Regeneric/universal-board-computer/(list of files, drawings)

Other design files:
sketch/bc-kkk.simu
sketch/bc-kkk_backup.simu
