Regeneric/universal-board-computer/sketch/universal_bc202.brd

## EAGLE design sketch/universal_bc202.brd (2021-03-08)

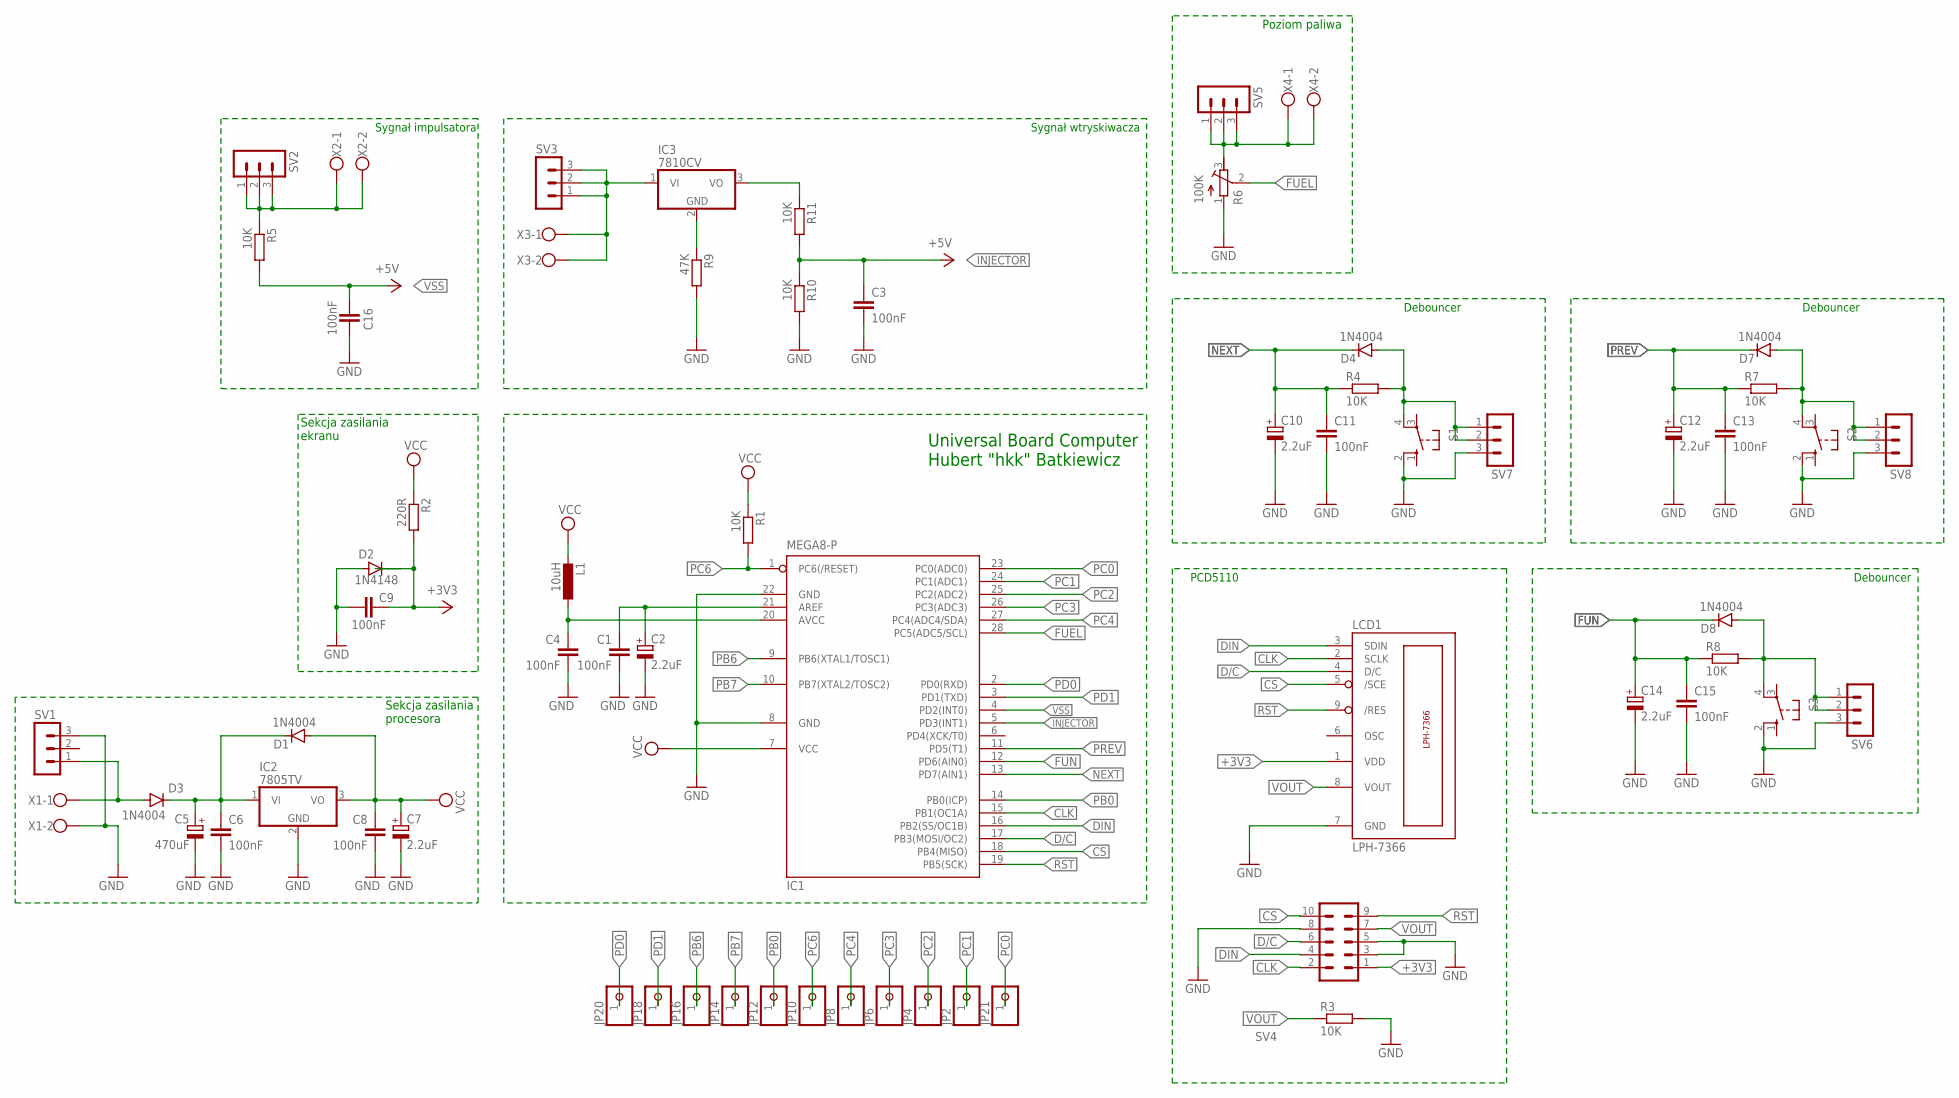
[picture p1: schematic universal_bc.sch]

Parts:
C1, C3, C4, C6, C8, C9, C11, C13, C15, C16: 100nF; C025-025X050
C2, C7, C10, C12, C14: 2.2uF; E2,5-6E
C5: 470uF; E2,5-6E
D1, D3, D4, D7, D8: 1N4004; DO41-10
D2: 1N4148; DO35-7
IC1: MEGA8-P; DIL28-3
IC2: 7805TV; TO220V
IC3: 7810CV; TO220V
JP2, JP4, JP6, JP8, JP10, JP12, JP14, JP16, JP18, JP20, JP21: PINHD-1X1; 1X01
L1: 10uH; 0207/2V
LCD1: LPH-7366
R1, R3, R4, R5, R7, R8, R10, R11: 10K; 0207/10
R2: 220R; 0207/10
R6: 100K; RTRIM3339P
R9: 47K; 0207/10
S1, S2, S3: 10-XX; B3F-10XX
SV1, SV2, SV3, SV5, SV6, SV7, SV8: MA03-1
SV4: MA05-2
X1, X2, X3, X4: W237-102

Connections:
+3V3: C9.1, D2.C, LCD1.1 (VDD), R2.2, SV4.1
CLK: IC1.15 (PB1(OC1A)), LCD1.2 (SCLK), SV4.2
CS: IC1.18 (PB4(MISO)), LCD1.5 (/SCE), SV4.10
D/C: IC1.17 (PB3(MOSI/OC2)), LCD1.4 (D/C), SV4.6
DIN: IC1.16 (PB2(SS/OC1B)), LCD1.3 (SDIN), SV4.4
FLOAT: R6.3 (E), SV5.1, SV5.2, SV5.3, X4.1, X4.2
FUEL: IC1.28 (PC5(ADC5/SCL)), R6.2 (S)
FUN: C14.+, C15.1, D8.C, IC1.12 (PD6(AIN0)), R8.1
GND: C1.2, C2.-, C3.2, C4.2, C5.-, C6.2, C7.-, C8.2, C9.2, C10.-, C11.2, C12.-, C13.2, C14.-, C15.2, C16.1, D2.A, IC1.8 (GND), IC1.22 (GND), IC2.2 (GND), LCD1.7 (GND), R3.2, R6.1 (A), R9.2, R10.2, S1.2 (S1), S2.2 (S1), S3.2 (S1), SV1.3, SV4.3, SV4.5, SV4.8, SV6.3, SV7.3, SV8.3, X1.2; also elsewhere on the board
INJECTOR: C3.1, IC1.5 (PD3(INT1)), R10.1, R11.2
unnamed: C1.1, C2.+, IC1.21 (AREF)
unnamed: C4.1, IC1.20 (AVCC), L1.1
unnamed: C5.+, C6.1, D1.C, D3.C, IC2.1 (VI)
unnamed: IC3.1 (VI), SV3.1, SV3.2, SV3.3, X3.1, X3.2
unnamed: D4.A, R4.2, S1.4 (P1), SV7.1, SV7.2
unnamed: D7.A, R7.2, S2.4 (P1), SV8.1, SV8.2
unnamed: D8.A, R8.2, S3.4 (P1), SV6.1, SV6.2
unnamed: D3.A, SV1.1, X1.1
unnamed: R5.1, SV2.1, SV2.2, SV2.3, X2.1, X2.2
unnamed: IC3.2 (GND), R9.1
unnamed: IC3.3 (VO), R11.1
NEXT: C10.+, C11.1, D4.C, IC1.13 (PD7(AIN1)), R4.1
PB0: IC1.14 (PB0(ICP)), JP12.1
PB6: IC1.9 (PB6(XTAL1/TOSC1)), JP16.1
PB7: IC1.10 (PB7(XTAL2/TOSC2)), JP14.1
PC0: IC1.23 (PC0(ADC0)), JP21.1
PC1: IC1.24 (PC1(ADC1)), JP2.1
PC2: IC1.25 (PC2(ADC2)), JP4.1
PC3: IC1.26 (PC3(ADC3)), JP6.1
PC4: IC1.27 (PC4(ADC4/SDA)), JP8.1
PC6: IC1.1 (PC6(/RESET)), JP10.1, R1.2; also elsewhere on the board
PD0: IC1.2 (PD0(RXD)), JP20.1
PD1: IC1.3 (PD1(TXD)), JP18.1
PREV: C12.+, C13.1, D7.C, IC1.11 (PD5(T1)), R7.1
RST: IC1.19 (PB5(SCK)), LCD1.9 (/RES), SV4.9
VCC: C7.+, C8.1, D1.A, IC1.7 (VCC), IC2.3 (VO), L1.2, R1.1, R2.1; also elsewhere on the board
VOUT: LCD1.8 (VOUT), R3.1, SV4.7
VSS: C16.2, IC1.4 (PD2(INT0)), R5.2

Notes on the sheet:
Sekcja zasilania procesora
Sekcja zasilania ekranu
Universal Board Computer Hubert "hkk" Batkiewicz
PCD5110
Sygnał impulsatora
Debouncer
Sygnał wtryskiwacza
Poziom paliwa

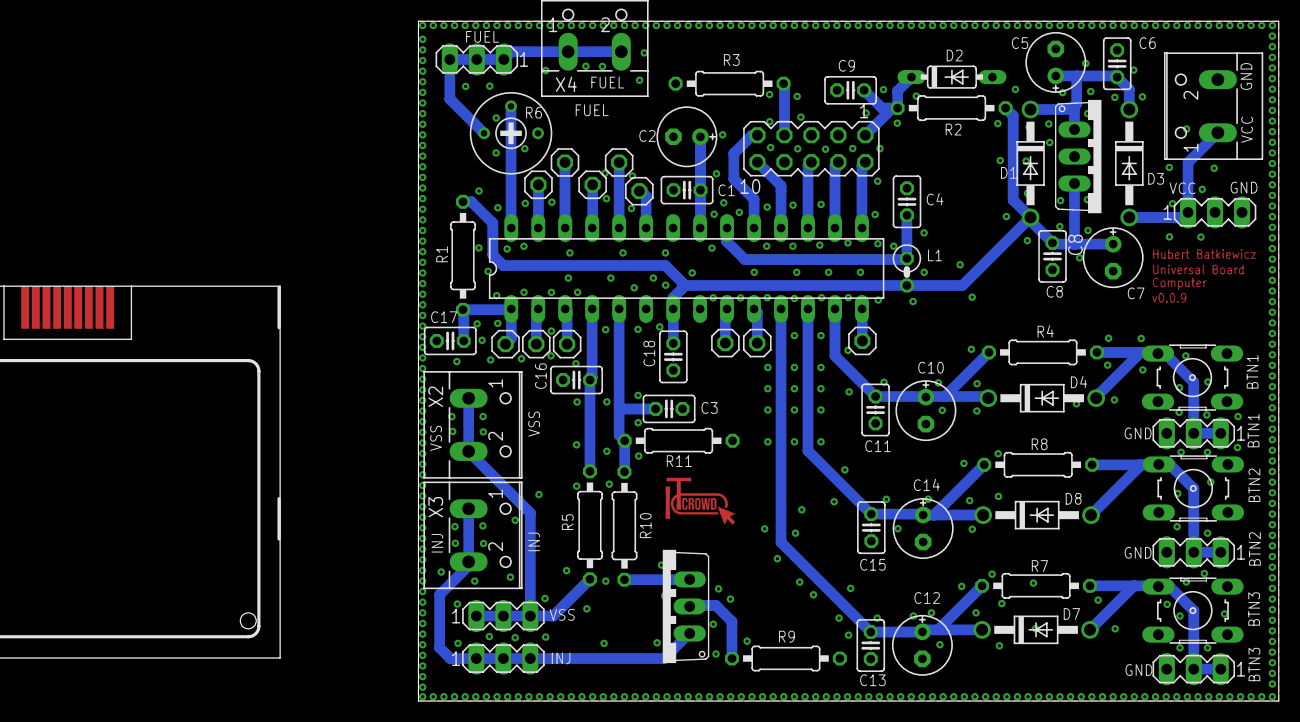
[picture p2: board universal_bc202.brd from above]

Board: 2 copper layers, 81.0 x 64.0 mm, 66 parts (0 on the bottom side), 38 nets.

Other parts of the board:
C17: 10nF; C025-025X050
C18: 100nF; C025-025X050

Their connections:
GND: C17.2, C18.2; also elsewhere on the board
PC6: C17.1; also elsewhere on the board
VCC: C18.1; also elsewhere on the board
