Regeneric/universal-board-computer/(commit log)

2021-01-27 Harmonic mean for avg speed and fuel cons
    [bc-kkk.simu, bc-kkk_backup.simu]
2021-01-27 EEPROM data type corrected for avgSpeedDivider
    [main.c]
2021-02-01 AGPL license, some tweaks with memory
    [bc-kkk_backup.simu]
2021-02-07 Memory optimalization (224... bytes of free space in flash).
    [bc-kkk_backup.simu]
2021-02-07 Memory optimalization and speed calibration menu
    [bc-kkk_backup.simu]
2021-02-16 Reset values from the EEPROM and display
    [bc-kkk.simu, bc-kkk_backup.simu]
2021-02-25 atmega 328 basic functionality
    [bc-kkk.simu, bc-kkk_backup.simu]
2021-02-28 Data reset in EEPROM - problem
    [bc-kkk.simu, bc-kkk_backup.simu]
2021-03-04 EEPROM problem
    [bc-kkk_backup.simu]
2021-03-08 Sailing time and acceleration measure on road
    [bc-kkk.simu, universal_bc.sch, universal_bc202.brd]
2022-12-16 UBC - new functions and bugfixes
    [bc-kkk.simu, bc-kkk_backup.simu]
