Regeneric/universal-board-computer/(notices)

Notices in the files:
chars.h:
​it under the terms of the GNU Affero General Public License as
published by the Free Software Foundation, either version 3 of the
​License, or (at your option) any later version.
